kyryliv-ivan/SmartClock_BlackPill/Core/Inc/main.h

#define SR_DATA_Pin   GPIO_PIN_1   // PA1 - SER
#define SR_CLK_Pin    GPIO_PIN_2   // PA2 - SRCLK
#define SR_LATCH_Pin  GPIO_PIN_3   // PA3 - RCLK
#define SR_GPIO_Port  GPIOA
#define SR_OE_Pin     GPIO_PIN_0   // PB0 - OE
#define SR_OE_Port    GPIOB
#define ENC_CLK_Pin   GPIO_PIN_12  // PB12 - encoder EC11 channel A
#define ENC_DT_Pin    GPIO_PIN_13  // PB13 - encoder EC11 channel B
#define ENC_SW_Pin    GPIO_PIN_14  // PB14 - encoder EC11 push button
#define ENC_GPIO_Port GPIOB
#define DS3231_ADDR (0x68 << 1)
