kyryliv-ivan/SmartClock_BlackPill/Core/Src/main.c

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
/* Includes ------------------------------------------------------------------*/
#include "main.h"
#include "adc.h"
#include "i2c.h"
#include "tim.h"
#include "usart.h"
#include "gpio.h"

/* USER CODE BEGIN Includes */

#include "sensors.h"
#include "led_display.h"
#include "oled.h"
#include "menu.h"
#include "alarm.h"
#include "wifi.h"
#include "radio.h"
#include "led_menu.h"
#include <stdio.h>
#include <string.h>

/* USER CODE END Includes */


void SystemClock_Config(void);
/* USER CODE BEGIN 0 */

/* --- Battery level (PA5 / ADC1_IN5) --------------------------------------
 R1/R2 100k/100k divider off the raw battery net (B+/B-, tapped before
 the LX-2's boost converter) halves Vbat into ADC range, C1 100nF buffers
 the divider's high source impedance for the sample. Voltage->percent
 isn't linear for Li-ion, so it's a piecewise-linear fit over a measured
 discharge curve instead of a straight scale.

 BATTERY_CAL_SCALE corrects for real-board error the raw formula can't
 know about (R1/R2 tolerance, actual Vref vs the assumed 3.3V) - measured
 once against a multimeter: board read 3.20V computed while the pack was
 actually at 3.57V, so scale = 3.57 / 3.20. Re-measure and update this if
 R1/R2 ever get swapped for a different pair. */
#define BATTERY_CAL_SCALE 1.115f

static uint8_t battery_read_percent(void)
{
	static const struct {
		float v;
		uint8_t pct;
	} curve[] = { { 4.20f, 100 }, { 4.10f, 90 }, { 4.00f, 80 }, { 3.90f, 70 }, {
			3.80f, 60 }, { 3.70f, 45 }, { 3.60f, 25 }, { 3.50f, 15 },
			{ 3.30f, 5 }, { 3.20f, 0 }, };
	const int n = sizeof(curve) / sizeof(curve[0]);

	/* Average 16 samples instead of trusting a single conversion - the
	 divider's high source impedance makes one-shot readings noisy enough
	 to visibly jitter the displayed percent by a couple of points. */
	uint32_t sum = 0;
	for (int i = 0; i < 16; i++)
	{
		HAL_ADC_Start(&hadc1);
		HAL_StatusTypeDef status = HAL_ADC_PollForConversion(&hadc1, 10);
		sum += (status == HAL_OK) ? HAL_ADC_GetValue(&hadc1) : 0;
		HAL_ADC_Stop(&hadc1);
	}
	uint32_t raw = sum / 16;

	float v_bat = (raw / 4095.0f) * 3.3f * 2.0f * BATTERY_CAL_SCALE;

	if (v_bat >= curve[0].v)
		return curve[0].pct;
	if (v_bat <= curve[n - 1].v)
		return curve[n - 1].pct;

	for (int i = 0; i < n - 1; i++)
	{
		if (v_bat <= curve[i].v && v_bat >= curve[i + 1].v)
		{
			float span_v = curve[i].v - curve[i + 1].v;
			float span_p = (float) curve[i].pct - (float) curve[i + 1].pct;
			float frac = (v_bat - curve[i + 1].v) / span_v;
			return (uint8_t) (curve[i + 1].pct + frac * span_p);
		}
	}
	return 0;
}

/* --- Incoming link from ESP32 (TIME:/STATUS: lines) ---------------------
 USART1's NVIC interrupt wasn't enabled when USART1 was generated via
 CubeMX, so RX is polled from the main loop instead of interrupt-driven -
 same non-blocking style as everything else here. */

static void esp32_handle_line(const char *line)
{
	if (strncmp(line, "TIME:", 5) == 0)
	{
		int year, month, day, h, m, s;

		if (sscanf(line + 5, "%d-%d-%dT%d:%d:%d", &year, &month, &day, &h, &m,
				&s) == 6)
		{
			/* Sync the RTC once, right after boot - DS3231 has its own
			 crystal and battery backup, it doesn't need per-second
			 correction, just an initial anchor to real time. */
			static uint8_t rtc_synced = 0;

			if (!rtc_synced)
			{
				time_set((uint8_t) h, (uint8_t) m, (uint8_t) day,
						(uint8_t) month, (uint8_t) (year % 100));
				rtc_synced = 1;
			}
		}
	} else if (strncmp(line, "SETTIME:", 8) == 0)
	{
		/* Manual override from the ESP32 setup webpage's Date & Time card -
		 unlike TIME: above, this applies every time it arrives, not just
		 once, since the user might deliberately correct the clock again
		 later. */
		int year, month, day, h, m, s;

		if (sscanf(line + 8, "%d-%d-%dT%d:%d:%d", &year, &month, &day, &h,
				&m, &s) == 6)
		{
			time_set((uint8_t) h, (uint8_t) m, (uint8_t) day,
					(uint8_t) month, (uint8_t) (year % 100));
		}
	} else if (strncmp(line, "STATUS:", 7) == 0)
	{
		/* "WIFI_OK,RADIO_PLAY,<ssid>" or "WIFI_DOWN,RADIO_STOP," (ssid
		 empty while disconnected) - feeds the WiFi submenu's Status entry. */
		char wifi_state[16] = "";
		char radio_state[16] = "";
		char ssid_buf[32] = "";

		sscanf(line + 7, "%15[^,],%15[^,],%31[^\n]", wifi_state, radio_state,
				ssid_buf);

		wifi_connected_set(strcmp(wifi_state, "WIFI_OK") == 0);
		wifi_ssid_set(ssid_buf);
		radio_playing_set(strcmp(radio_state, "RADIO_PLAY") == 0);
	} else if (strncmp(line, "EQ:", 3) == 0)
	{
		int l0, l1, l2, l3;

		if (sscanf(line + 3, "%d,%d,%d,%d", &l0, &l1, &l2, &l3) == 4)
		{
			eq_level_set(0, (uint8_t) l0);
			eq_level_set(1, (uint8_t) l1);
			eq_level_set(2, (uint8_t) l2);
			eq_level_set(3, (uint8_t) l3);
		}
	} else if (strncmp(line, "SETUP_MODE:", 11) == 0)
	{
		uint8_t on = (uint8_t) (line[11] == '1');
		wifi_setup_mode_set(on);

		if (on)
		{
			/* ESP32 stops sending STATUS:/EQ: entirely while its own
			   loop() is busy running the setup AP - without this, WiFi/
			   radio state here would just stay frozen at whatever it was
			   right before setup mode started instead of reflecting
			   reality (nothing is connected or playing right now). */
			wifi_connected_set(0);
			radio_playing_set(0);
		}
	}
}

static void esp32_uart_poll(void)
{
	static char rx_line[40];
	static uint8_t rx_len = 0;

	if (__HAL_UART_GET_FLAG(&huart1, UART_FLAG_RXNE))
	{
		uint8_t c = (uint8_t) (huart1.Instance->DR & 0xFF);

		if (c == '\n')
		{
			rx_line[rx_len] = '\0';
			esp32_handle_line(rx_line);
			rx_len = 0;
		} else if (rx_len < sizeof(rx_line) - 1)
		{
			rx_line[rx_len++] = (char) c;
		}
		/* line too long - drop silently, rx_len stops growing until '\n' */
	}
}

void gpio_init(void)
{
	led_display_init();
}

/* USER CODE END 0 */

/**
 * @brief  The application entry point.
 * @retval int
 */
int main(void)
{

	/* MCU Configuration--------------------------------------------------------*/

	/* Reset of all peripherals, Initializes the Flash interface and the Systick. */
	HAL_Init();

	/* Configure the system clock */
	SystemClock_Config();

	/* Initialize all configured peripherals */
	MX_GPIO_Init();
	MX_TIM10_Init();
	MX_I2C1_Init();
	MX_USART1_UART_Init();
	MX_ADC1_Init();
	/* USER CODE BEGIN 2 */

	gpio_init();
	HAL_TIM_Base_Start_IT(&htim10);

	oled_init();

	sensors_init();
	led_menu_init();
	menu_init();

	/* slow-changing, so it's read on its own multi-second tick rather than
	 every clock redraw. battery_pct_f is a smoothed (EMA) running value -
	 the 16x-averaged reading from battery_read_percent() still moves a
	 point or two between updates, so this blends each new reading in
	 gradually instead of snapping the displayed number straight to it. */
	uint32_t battery_tick = 0;
	float battery_pct_f = (float) battery_read_percent();
	uint8_t battery_pct = (uint8_t) (battery_pct_f + 0.5f);

	char last_time[16] = "";

	/* USER CODE END 2 */

	/* Infinite loop */
	/* USER CODE BEGIN WHILE */
	while (1)
	{

		esp32_uart_poll();

		/* --- Encoder / button -> UI state --------------------------------
		 Runs every pass (not gated to any tick) so the menu feels
		 responsive to rotation/tap, independent of the 200 ms RTC poll. */
		{
			int32_t pos_delta = encoder_delta_get();

			if (alarm_is_ringing())
			{
				if (encoder_tapped_get())
				{
					alarm_stop();
					last_time[0] = '\0';

					const char *cmd = "ALARM_STOP:1\n";
					HAL_UART_Transmit(&huart1, (uint8_t*) cmd,
							(uint16_t) strlen(cmd), 100);
				}
			}
			else
			{
				if (encoder_tapped_get())
					menu_tap();

				menu_rotate(pos_delta);
			}

			menu_tick();
			menu_draw();

			if (menu_consume_clock_redraw())
				last_time[0] = '\0';
		}

		/* Sensors - heavy I2C work (AHT20 has a blocking HAL_Delay(80)).
		 Spread bmp280/aht20/bh1750 across three separate ticks instead of
		 doing them back-to-back in one block every second. BH1750 is in
		 continuous mode, so its read is just a 2-byte fetch - no delay. */

		sensors_poll();

		if (HAL_GetTick() - battery_tick >= 5000)
		{
			battery_tick = HAL_GetTick();
			battery_pct_f = battery_pct_f * 0.7f
					+ (float) battery_read_percent() * 0.3f;
			battery_pct = (uint8_t) (battery_pct_f + 0.5f);
		}

		static uint32_t last_read = 0;

		if (HAL_GetTick() - last_read >= 200)
		{
			last_read = HAL_GetTick();

			/* No-op unless Night Mode is on - lux_get() itself only
			   refreshes every ~2.1s (sensors_poll()'s round-robin), calling
			   this more often than that just re-applies the same smoothed
			   value, which is harmless. */
			led_night_mode_apply(lux_get());

			/* QR display is entirely menu.c's job (UI_WIFI_QR) - this loop
			   only needs to stay out of its way via menu_active() below. */
			if (!rtc_ok_get())
			{
				led_display_set_error();

				if (!menu_active())
				{
					oled_clear();
					oled_line_large(0, 24, "RTC ERROR");
					oled_flush();
				}
			} else
			{
				led_menu_tick();
				if (alarm_check(hour_get(), minute_get()))
				{
					char cmd[20];
					int len = sprintf(cmd, "ALARM_SOUND:%u\n",
							(unsigned) alarm_melody_get());
					HAL_UART_Transmit(&huart1, (uint8_t*) cmd,
							(uint16_t) len, 100);
				}

				char time_str[16];
				char date_str[16];

				sprintf(time_str, "%02d:%02d:%02d", hour_get(), minute_get(),
						second_get());

				if (alarm_is_ringing())
				{
					led_display_set_colon((HAL_GetTick() / 300) % 2);

					if (!menu_active())
					{
						oled_clear();
						oled_line_large(0, 20, "ALARM!");
						oled_line_small(0, 44, "tap to stop");
						oled_flush();
					}
				}
				else if (menu_active())
				{
					/* menu.c owns the OLED right now - leave it alone */
				}
				else if (strcmp(time_str, last_time) != 0)
				{
					strcpy(last_time, time_str);
					sprintf(date_str, "%02d.%02d.20%02d", day_get(),
							month_get(), year_get());

					char batt_str[8];
					sprintf(batt_str, "%3d%%", battery_pct);
					char sensor_str[16];

					oled_clear();
					oled_line_large(0, 0, time_str);
					oled_line_small(100, 4, batt_str);
					oled_line_small(0, 24, date_str);

					sprintf(sensor_str, "T:%.1fC H:%.0f%%", temperature_get(),
							humidity_get());
					oled_line_small(0, 38, sensor_str);

					sprintf(sensor_str, "P:%.0f L:%.0flx", pressure_get(),
							lux_get());
					oled_line_small(0, 52, sensor_str);
					oled_flush();
				}
			}
		}

		/* USER CODE END WHILE */

		/* USER CODE BEGIN 3 */
	}
	/* USER CODE END 3 */
}

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
