kyryliv-ivan/SmartClock_BlackPill/Core/Src/UI/wifi.c

#include "wifi.h"
#include "oled.h"
#include <string.h>

static const char *labels[] = { "Status", "Reconnect", "QR Code", "Change WiFi" };
#define COUNT (sizeof(labels) / sizeof(labels[0]))

static uint8_t connected = 0;
static char    ssid[32] = "";

uint8_t wifi_submenu_count(void) { return COUNT; }

const char *wifi_submenu_label(uint8_t index)
{
	return labels[index];
}

wifi_action_t wifi_submenu_tap(uint8_t index)
{
	if (index == 2) /* QR Code - just display it, no WiFi state change */
		return WIFI_ACTION_SHOW_QR;
	if (index == 3) /* Change WiFi - erase saved creds, back to setup AP */
		return WIFI_ACTION_FORGET;

	return WIFI_ACTION_NONE; /* Status / Reconnect handled by menu.c */
}

void wifi_connected_set(uint8_t c) { connected = c; }
uint8_t wifi_connected_get(void)   { return connected; }

void wifi_ssid_set(const char *s)
{
	strncpy(ssid, s, sizeof(ssid) - 1);
	ssid[sizeof(ssid) - 1] = '\0';
}

const char *wifi_ssid_get(void) { return ssid; }

/* QR payload: "WIFI:T:WPA;S:SmartClock;P:SmartClock;;" - fixed setup AP
   credentials (SSID and password both "SmartClock", 10 chars - clears
   WPA2's 8-character minimum), so the QR pattern itself is always the
   same and can be pre-rendered once instead of encoded on-device.
   31x31 modules at 2x2px each = 62x62px is the largest *clean* integer
   scale that fits the 64px-tall screen (3px/module would need 93px) -
   nearest-neighbor stretched by 2px to 64x64 (fills the screen height
   exactly) and re-verified against a live decoder afterwards, so a
   couple of module edges are 3px instead of 2px rather than leaving
   margin unused. Quiet zone trimmed to 1 module before the stretch (0
   fails to scan, 1 decodes reliably - verified separately). Row-major
   MSB-first (matches ssd1306_DrawBitmap / oled_draw_bitmap format) -
   verified bit-for-bit against the source QR matrix before embedding. */
#define WIFI_QR_W 64
#define WIFI_QR_H 64

static const uint8_t wifi_qr_bitmap[] = {
	0x00, 0x00, 0x00, 0x00, 0x00, 0x00, 0x00, 0x00,
	0x00, 0x00, 0x00, 0x00, 0x00, 0x00, 0x00, 0x00,
	0x3F, 0xFF, 0x86, 0x1E, 0x7F, 0xE1, 0xFF, 0xFC,
	0x3F, 0xFF, 0x86, 0x1E, 0x7F, 0xE1, 0xFF, 0xFC,
	0x30, 0x03, 0x81, 0xF8, 0x78, 0x79, 0xC0, 0x0C,
	0x30, 0x03, 0x81, 0xF8, 0x78, 0x79, 0xC0, 0x0C,
	0x33, 0xF3, 0x9F, 0x98, 0x78, 0x79, 0xCF, 0xCC,
	0x33, 0xF3, 0x9F, 0x98, 0x78, 0x79, 0xCF, 0xCC,
	0x33, 0xF3, 0x87, 0xE0, 0x00, 0x61, 0xCF, 0xCC,
	0x33, 0xF3, 0x87, 0xE0, 0x00, 0x61, 0xCF, 0xCC,
	0x33, 0xF3, 0x81, 0x86, 0x66, 0x61, 0xCF, 0xCC,
	0x33, 0xF3, 0x81, 0x86, 0x66, 0x61, 0xCF, 0xCC,
	0x30, 0x03, 0x86, 0x00, 0x78, 0x79, 0xC0, 0x0C,
	0x30, 0x03, 0x86, 0x00, 0x78, 0x79, 0xC0, 0x0C,
	0x3F, 0xFF, 0x99, 0x99, 0x99, 0x99, 0xFF, 0xFC,
	0x3F, 0xFF, 0x99, 0x99, 0x99, 0x99, 0xFF, 0xFC,
	0x3F, 0xFF, 0x99, 0x99, 0x99, 0x99, 0xFF, 0xFC,
	0x00, 0x00, 0x1F, 0x9F, 0x87, 0x98, 0x00, 0x00,
	0x00, 0x00, 0x1F, 0x9F, 0x87, 0x98, 0x00, 0x00,
	0x3F, 0x3F, 0xF9, 0xE1, 0x98, 0x7F, 0xC0, 0xC0,
	0x3F, 0x3F, 0xF9, 0xE1, 0x98, 0x7F, 0xC0, 0xC0,
	0x03, 0xCC, 0x79, 0xE0, 0x1F, 0x99, 0xF3, 0xF0,
	0x03, 0xCC, 0x79, 0xE0, 0x1F, 0x99, 0xF3, 0xF0,
	0x30, 0x33, 0x86, 0x06, 0x01, 0x98, 0x33, 0xFC,
	0x30, 0x33, 0x86, 0x06, 0x01, 0x98, 0x33, 0xFC,
	0x0F, 0x3C, 0x78, 0x60, 0x1E, 0x7F, 0xF3, 0x3C,
	0x0F, 0x3C, 0x78, 0x60, 0x1E, 0x7F, 0xF3, 0x3C,
	0x0F, 0x33, 0x98, 0x18, 0x7F, 0xFF, 0xFF, 0x3C,
	0x0F, 0x33, 0x98, 0x18, 0x7F, 0xFF, 0xFF, 0x3C,
	0x3C, 0xF0, 0x06, 0x7E, 0x19, 0x98, 0x03, 0xF0,
	0x3C, 0xF0, 0x06, 0x7E, 0x19, 0x98, 0x03, 0xF0,
	0x00, 0xCF, 0xE0, 0x79, 0x9F, 0x81, 0xF0, 0x3C,
	0x00, 0xCF, 0xE0, 0x79, 0x9F, 0x81, 0xF0, 0x3C,
	0x0C, 0xF0, 0x18, 0x1F, 0xFE, 0x01, 0xFC, 0x00,
	0x0C, 0xF0, 0x18, 0x1F, 0xFE, 0x01, 0xFC, 0x00,
	0x0F, 0x03, 0xE1, 0xE1, 0xF8, 0x1F, 0xF3, 0xC0,
	0x0F, 0x03, 0xE1, 0xE1, 0xF8, 0x1F, 0xF3, 0xC0,
	0x00, 0xF0, 0x1E, 0x61, 0x9F, 0xFF, 0xF0, 0x30,
	0x00, 0xF0, 0x1E, 0x61, 0x9F, 0xFF, 0xF0, 0x30,
	0x33, 0x33, 0xE1, 0x86, 0x07, 0x9E, 0x3C, 0xFC,
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
};

void wifi_qr_draw(void)
{
	oled_clear();
	/* centered: (128-64)/2 = 32, (64-64)/2 = 0 - fills the full screen
	   height */
	oled_draw_bitmap(32, 0, wifi_qr_bitmap, WIFI_QR_W, WIFI_QR_H);
	oled_flush();
}

static uint8_t setup_mode = 0;

void wifi_setup_mode_set(uint8_t on) { setup_mode = on; }
uint8_t wifi_setup_mode_get(void)    { return setup_mode; }
