kyryliv-ivan/SmartClock_BlackPill/(commit log)

2026-08-14 Initial STM32 project
2026-08-16 Add DS3231 RTC via I2C1 and display time on LEDs
2026-08-18 Add AHT20 + BMP280 sensors, show temperature/humidity/pressure on OLED
2026-08-18 Add BH1750 light sensor, show lux on OLED
2026-08-18 Add rotary encoder + OLED menu, ESP32 UART link
2026-08-18 Add battery percentage via PA5 ADC divider
2026-08-24 Add sensor abstraction layer.
2026-08-25 Add oled and led abstraction layer.
2026-09-02 Add encoder logic.
2026-09-06 fix logic connection wifi.
    [SmartClock_ESP32.ino, main.c, menu.c, wifi.c, wifi.h]
2026-09-27 Add README and technical documentation
    Adds a project overview, feature list, architecture summary, menu
    tree, and board photos, plus the full PDF documentation (schematics,
    PCB layout, clock configuration, BOM) under docs/.
2026-09-27 Add more photos of assembled board
2026-09-27 Restore full quality for schematic pages in PDF documentation
